iSECPartners/R2B2/BruteController/pinpad.jpg

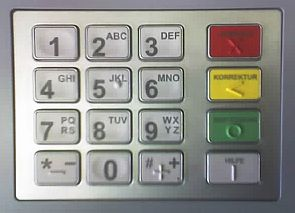
BruteController/pinpad.jpg
