iSECPartners/R2B2/stl_3d_printer_files/mountingbracket_fixed.stl

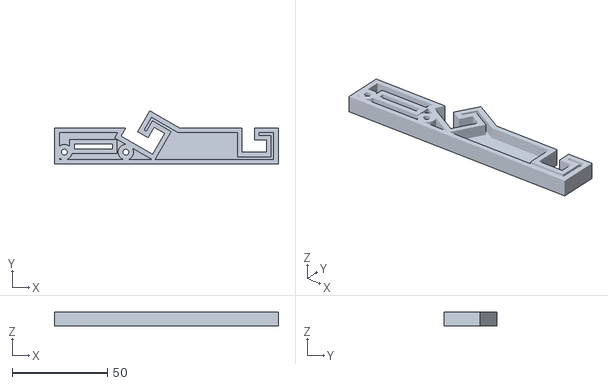
[picture p9: CAD file, 2013-08-15]
stl_3d_printer_files/mountingbracket_fixed.stl
117.3 x 28.0 x 7.50
