iSECPartners/R2B2/stl_3d_printer_files/end effector v2.STL

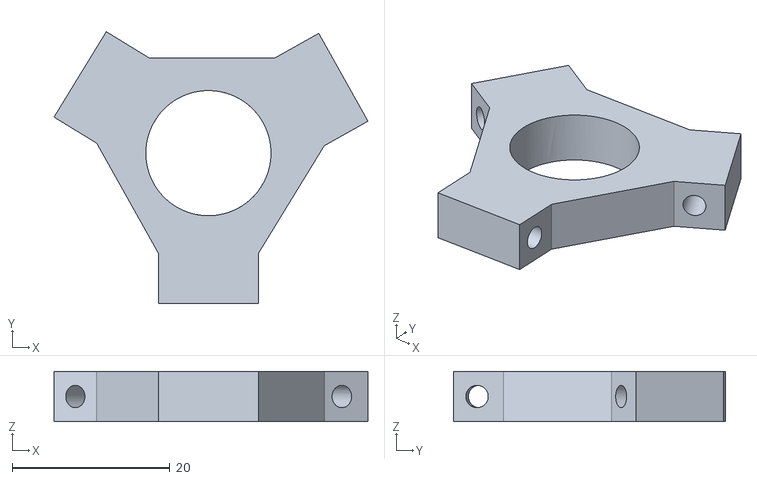
[picture p10: CAD file, 2013-08-15]
stl_3d_printer_files/end effector v2.STL
39.8 x 34.5 x 6.35
