iSECPartners/R2B2/stl_3d_printer_files/bicep.STL

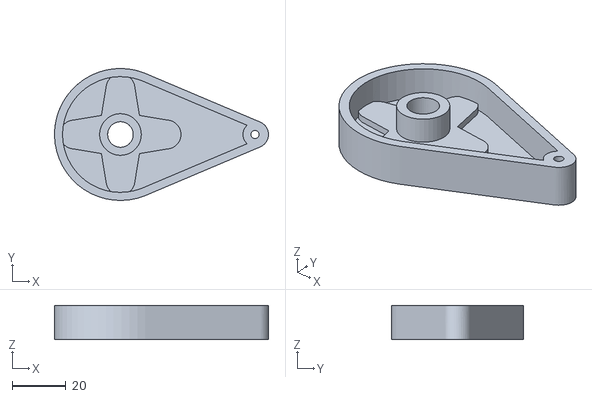
[picture p11: CAD file, 2013-08-15]
stl_3d_printer_files/bicep.STL
79.5 x 49.0 x 12.7
