iSECPartners/R2B2/Build Instructions.txt

1. Check to make sure you have everything 

2. Assemble 6 rods from Tamiya kits. 1. Remove plastic from sprues 

3. screw plastic onto ends of rods (all rods should be matching length) 

4. pull brass joints onto plastic via screws, 

5. Assemble base mount pieces via friction fit. Attempt to make as level as
   possible 

6. Insert servos into base mount holes, output gear should be farthest from
   mount.  Output gear is on the side closest to an angle, not the flat side.
   If you don't have a good fit, it could be that you aren't using the specced
   servo, and the part where you do the mount appears to vary a bit for
   different models. Might have to get nasty with a knife, dremel, etc. 

7. Install Arduino software on PC 

8. Plug Arduino into wall adapter and wall adapter into wall  A light should
   blink if your Arduino is in factory state 

9. Plug Arduino into USB 

10. Send R2B2 sketch to Arduino 

11. Open serial connection to Arduino (57.6k, 8n1) (Arduino IDE has serial
    terminal built-in, or use your favorite) 

12. Status will display on serial console 

13. Be careful and wire up your servos to the arduino correctly (Servo will
    make some noise as the gear moves) 

14. Your servos are now being set by the arduino to 90 degrees. 

15. Use 4-pronged servo horns and attach to robot bicep with servo horn screws
    (or hot glue, or whatever) 

16. Attach servo horn+bicep to servo such that the bicep points out from the
    center and is parallel to the base mount. 

17. Once horn is aligned to 90 degrees, screw horn to servo. 

18. Disconnect PC and power from Arduino 

19. Push grommet through effector, then push nylon threaded tube through
    grommet. 

20. Pull rubber stylus dome over screw head, then screw into nylon threaded
    tube 

21. Screw 6 threaded rod assemblies onto effector using brass screws.  After
    screw is fully tightened, back out screw while holding brass hex area with
    pliers so that screw head does not interfere with plastic motion on ball,
    but brass hex is still flush with effector. 

22. Screw 6 threaded rod assemblies onto biceps using same procedure as for
    effector 

23. Reconnect power and USB to computer. Rerun R2B2 Sketch and serial terminal.
    Effector should move to (0,0,0) position, all biceps should be parallel to
    base mount. 

24. Send test commands via serial terminal to verify motion is correct 

25. recenter R2B2 

26. disconnect usb and power 

27. Mount the robot on a frame.  We've had great luck with camera tripods.
    You'll need roughly 9" of height.
