iSECPartners/R2B2/stl_3d_printer_files/readme.txt

These files originally by Dan Royer (marginallyclever.com).

Mirroring in this repo for posterity.
