iSECPartners/R2B2/BruteController/calibration-card.docx

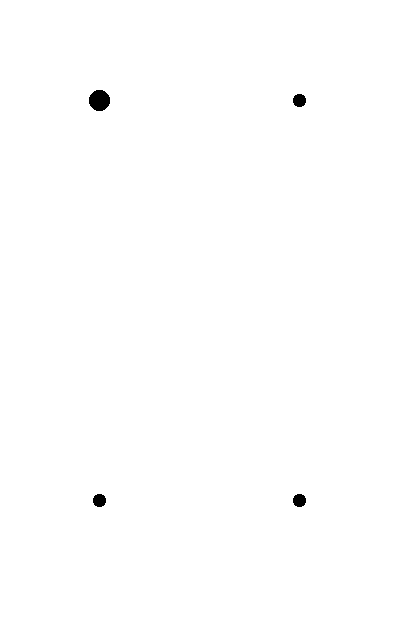
[picture p12: figure]
