iSECPartners/R2B2/(commit log)

2013-08-15 Initial import
    [bicep.STL, end effector v2.STL, mountingbracket_fixed.stl, robot parts list.xlsx]
2013-08-15 Add in BruteController
    [stats.csv]
